patrickbuco08/sugarcane-system/docs/images/ca3f5f8f-66e3-44d3-900d-84d682a41a90.jpeg

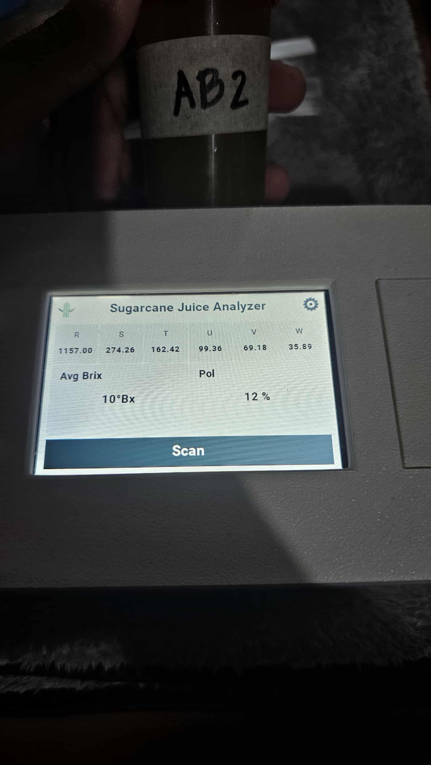
docs/images/ca3f5f8f-66e3-44d3-900d-84d682a41a90.jpeg
