patrickbuco08/sugarcane-system/docs/images/af6ad484-1343-4f59-851e-ec697a815010.jpeg

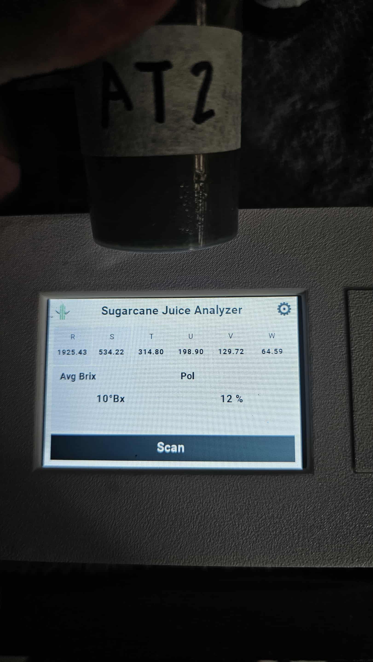
docs/images/af6ad484-1343-4f59-851e-ec697a815010.jpeg
