patrickbuco08/sugarcane-system/README.md

# sugarcane-system

## getting "The file will have its original line endings in your working directory"??
git config --global core.autocrlf true
