patrickbuco08/sugarcane-system/model/README.md

# Sugarcane Yield Prediction Model

This directory contains the machine learning assets for sugarcane yield prediction.

## 🚀 Environment Setup

1. Create a conda environment (Python 3.10)
   ```bash
   conda create -n sugarcane python=3.10
   ```

2. List all available conda environments:
    ```bash
    conda env list
    # or
    conda info --envs
    ```

3. Activate the environment
   ```bash
   conda activate sugarcane
   ```

4. Install dependencies
   ```bash
   conda install pandas numpy scikit-learn matplotlib seaborn jupyter
   ```

If you prefer pip:
```bash
pip install -r requirements.txt
```

## 📁 Project Structure

```
model/
├── README.md                       # This guide
├── train.py            # Training script
└── sugarcane_dataset.csv           # Sample training data template
```

## 🛠 Usage

1. Prepare your dataset following `sugarcane_dataset.csv`.
2. Run the training script:
   ```bash
   python train.py <path/to/sugarcane_dataset.csv>
   ```
3. Check console/log output for metrics and saved artifacts (if implemented in the script).

## Formulas

### Brix
```
Brix = Intercept + (R * Coefficient_R) + (S * Coefficient_S) + (T * Coefficient_T) + (U * Coefficient_U) + (V * Coefficient_V) + (W * Coefficient_W)
```

### Pol
```
Pol = Intercept + (R * Coefficient_R) + (S * Coefficient_S) + (T * Coefficient_T) + (U * Coefficient_U) + (V * Coefficient_V) + (W * Coefficient_W)
```

### compare predictions
```
python compare_predictions.py
```

## 📊 Dependencies

- Python 3.10
- pandas
- numpy
- scikit-learn
- matplotlib (optional: plots)
- seaborn (optional: plots)
- jupyter (optional: notebooks)

## 🔍 Tips

- Ensure your CSV matches the expected columns in `train.py`.
- Use a virtual environment to avoid dependency conflicts.
- Version your datasets and models for reproducibility.

## 🤝 Contributing

1. Create a new branch.
2. Make your changes with clear commit messages.
3. Open a pull request.

## 📝 License

This project is licensed under the MIT License.
