patrickbuco08/sugarcane-system/docs/images/0d0d7b87-3aa7-4536-8bcb-4d0c79ba6991.jpeg

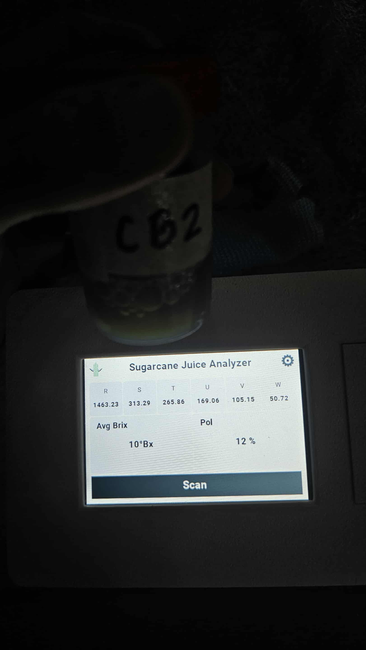
docs/images/0d0d7b87-3aa7-4536-8bcb-4d0c79ba6991.jpeg
