patrickbuco08/sugarcane-system/docs/images/1b9cdef6-652d-4af6-95f5-f85dae05fc5d.jpeg

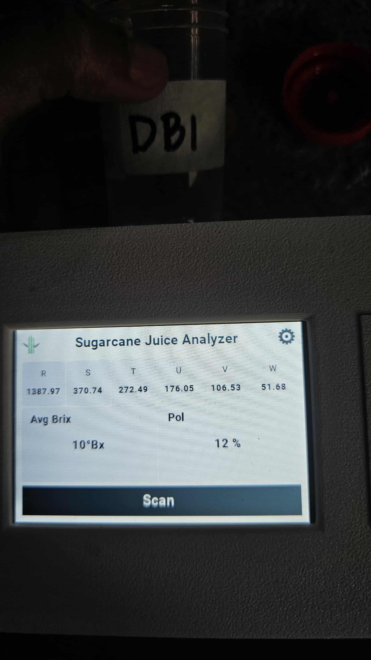
docs/images/1b9cdef6-652d-4af6-95f5-f85dae05fc5d.jpeg
