patrickbuco08/sugarcane-system/docs/images/1bac9211-0c35-43af-a18d-26ac61dd8825.jpeg

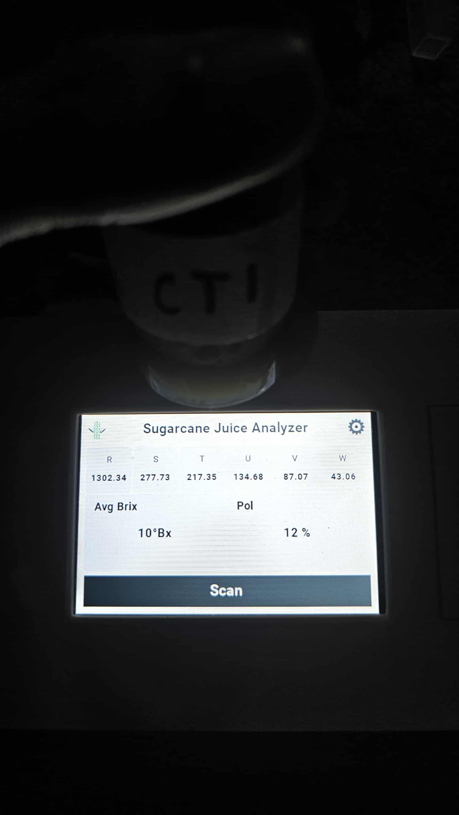
docs/images/1bac9211-0c35-43af-a18d-26ac61dd8825.jpeg
