patrickbuco08/sugarcane-system/docs/images/3c724693-fbf5-43bd-ac4e-58715e780c49.jpeg

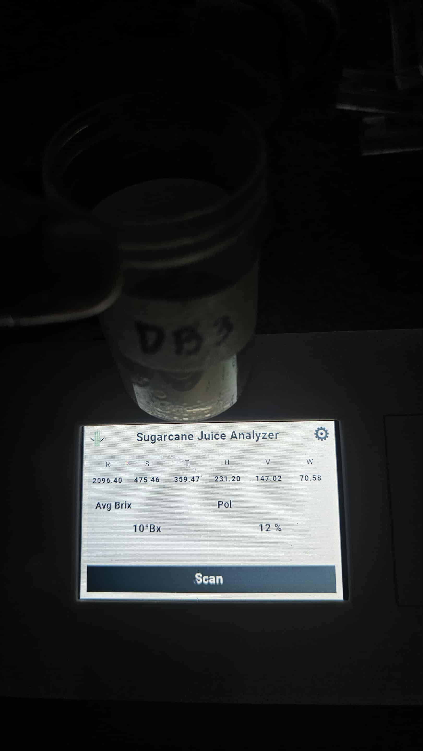
docs/images/3c724693-fbf5-43bd-ac4e-58715e780c49.jpeg
