patrickbuco08/sugarcane-system/docs/images/05ad4cc8-e1f9-4766-a3b2-0679a9f3559e.jpeg

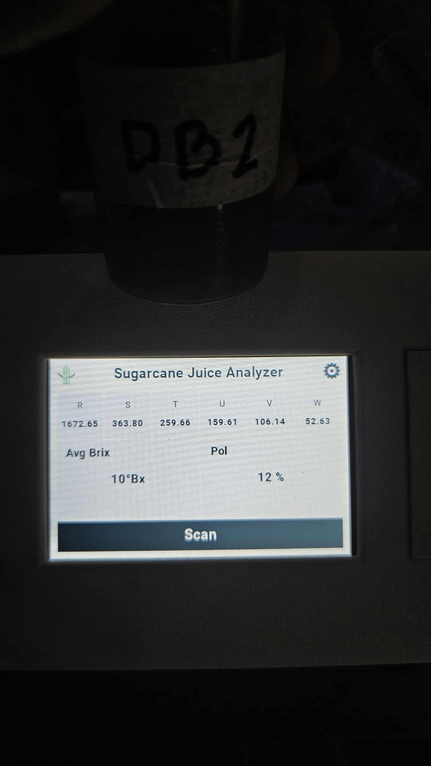
docs/images/05ad4cc8-e1f9-4766-a3b2-0679a9f3559e.jpeg
