patrickbuco08/sugarcane-system/docs/images/6ccf285b-375e-4190-a819-16bb841706b2.jpeg

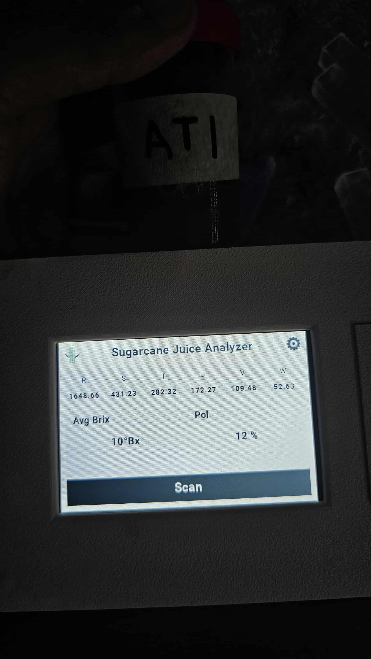
docs/images/6ccf285b-375e-4190-a819-16bb841706b2.jpeg
