patrickbuco08/sugarcane-system/docs/images/7b108888-901c-46f5-8a62-2943c57e6c4b.jpeg

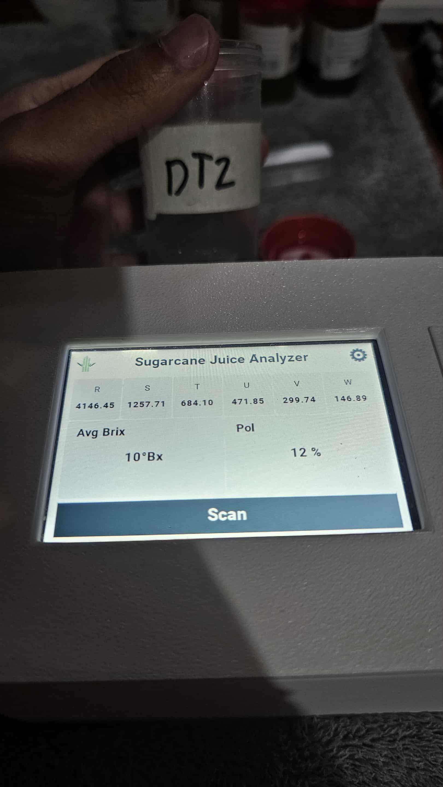
docs/images/7b108888-901c-46f5-8a62-2943c57e6c4b.jpeg
