patrickbuco08/sugarcane-system/docs/images/8acf1e33-d534-42b8-972c-b1b3c7cef1ff.jpeg

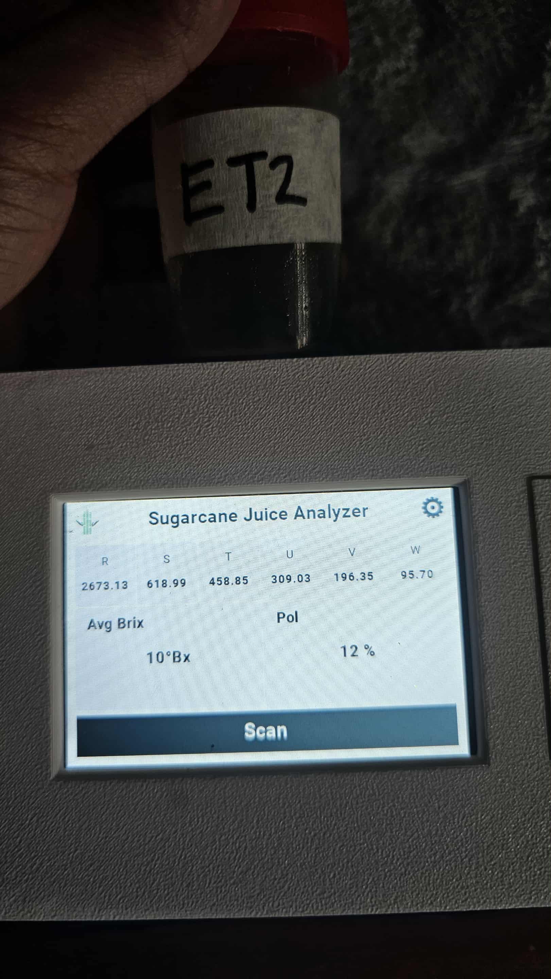
docs/images/8acf1e33-d534-42b8-972c-b1b3c7cef1ff.jpeg
