patrickbuco08/sugarcane-system/docs/images/9fb0ab20-7d77-44ea-ab5d-9b9a8afbc824.jpeg

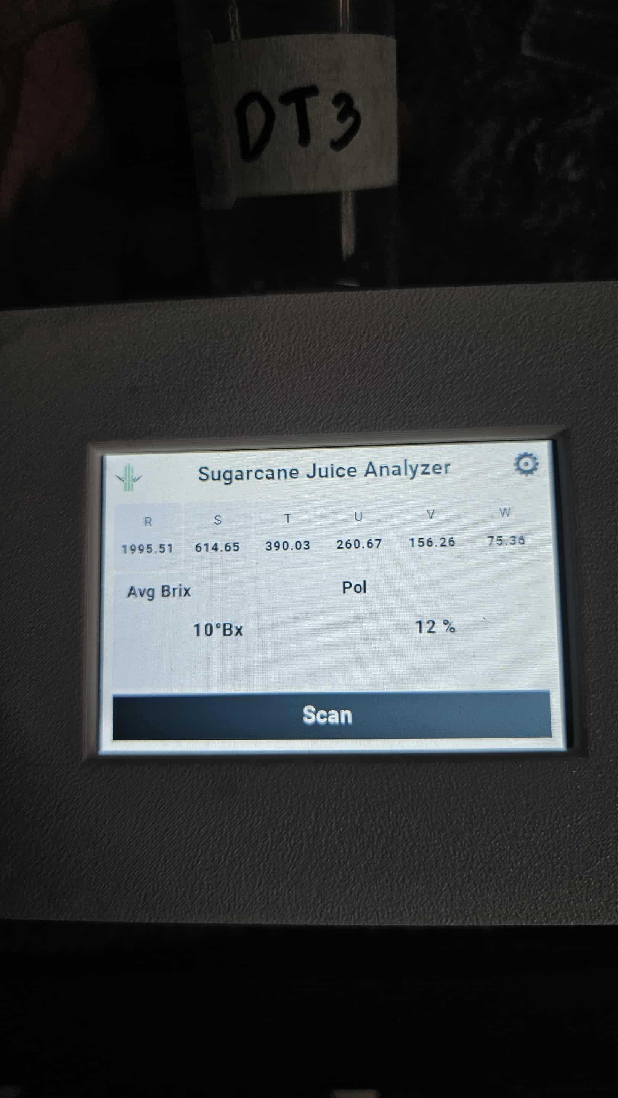
docs/images/9fb0ab20-7d77-44ea-ab5d-9b9a8afbc824.jpeg
