patrickbuco08/sugarcane-system/docs/images/34d0c28a-2cec-43b3-86b0-2dbcf392f2a3.jpeg

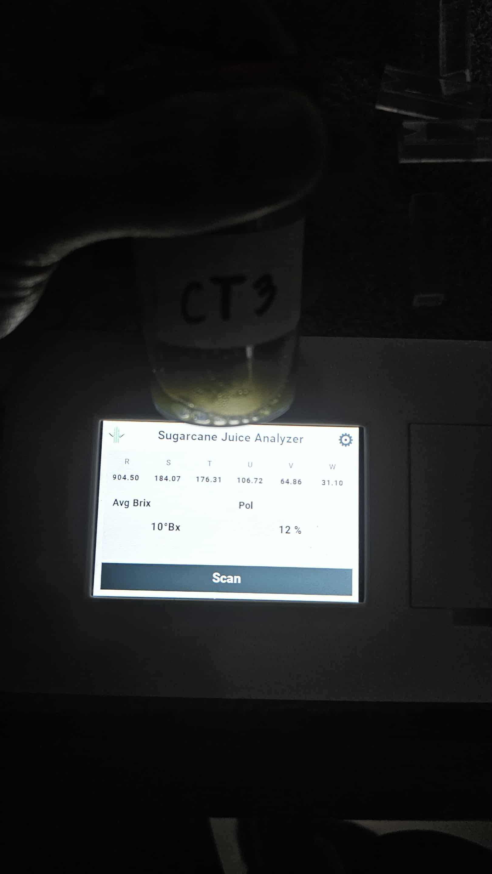
docs/images/34d0c28a-2cec-43b3-86b0-2dbcf392f2a3.jpeg
