patrickbuco08/sugarcane-system/docs/images/43f1e836-a402-4206-a96f-d187ac1180a9.jpeg

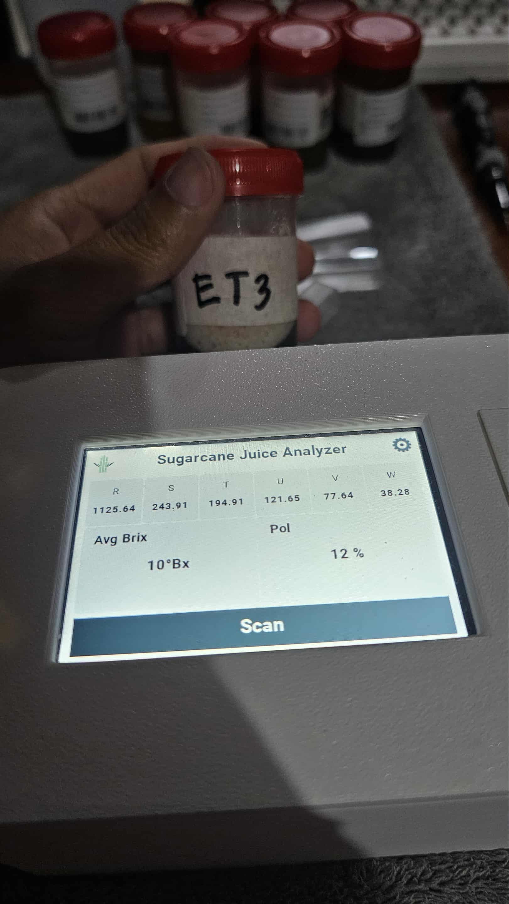
docs/images/43f1e836-a402-4206-a96f-d187ac1180a9.jpeg
