patrickbuco08/sugarcane-system/docs/images/47b05fc7-6812-40f8-93ec-f37b07b2d239.jpeg

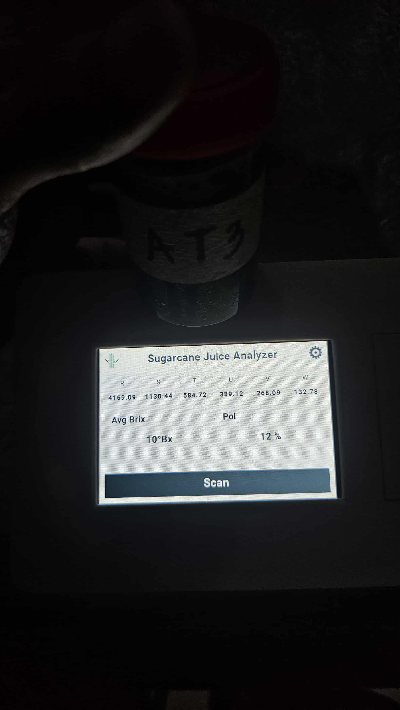
docs/images/47b05fc7-6812-40f8-93ec-f37b07b2d239.jpeg
