patrickbuco08/sugarcane-system/docs/images/57d3f323-b372-4297-8f44-9628997a7a36.jpeg

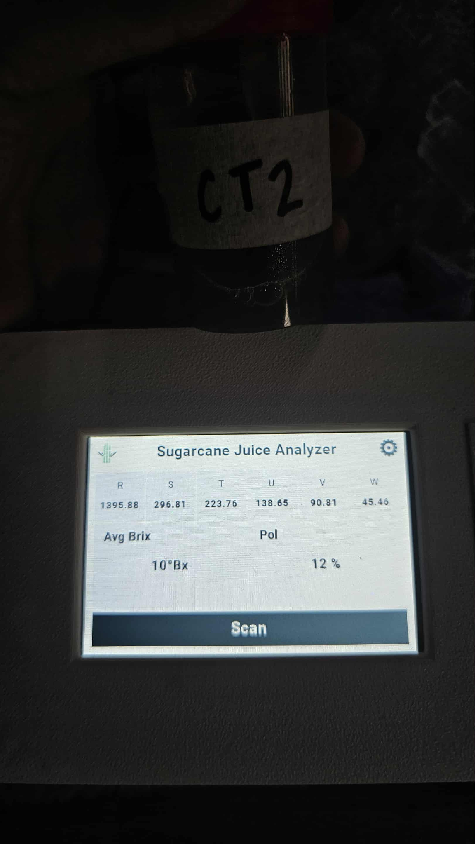
docs/images/57d3f323-b372-4297-8f44-9628997a7a36.jpeg
