patrickbuco08/sugarcane-system/docs/images/61f1e5ee-3955-455a-9479-f2e9a472deef.jpeg

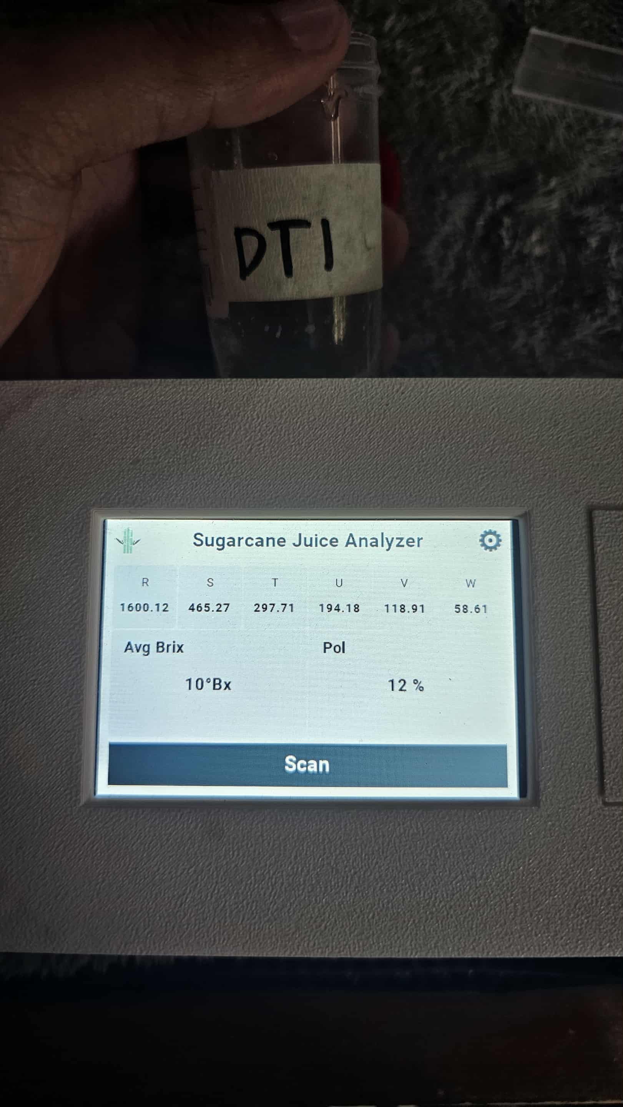
docs/images/61f1e5ee-3955-455a-9479-f2e9a472deef.jpeg
