patrickbuco08/sugarcane-system/docs/images/975b32c4-0c78-48cd-9f11-4fb7340f848e.jpeg

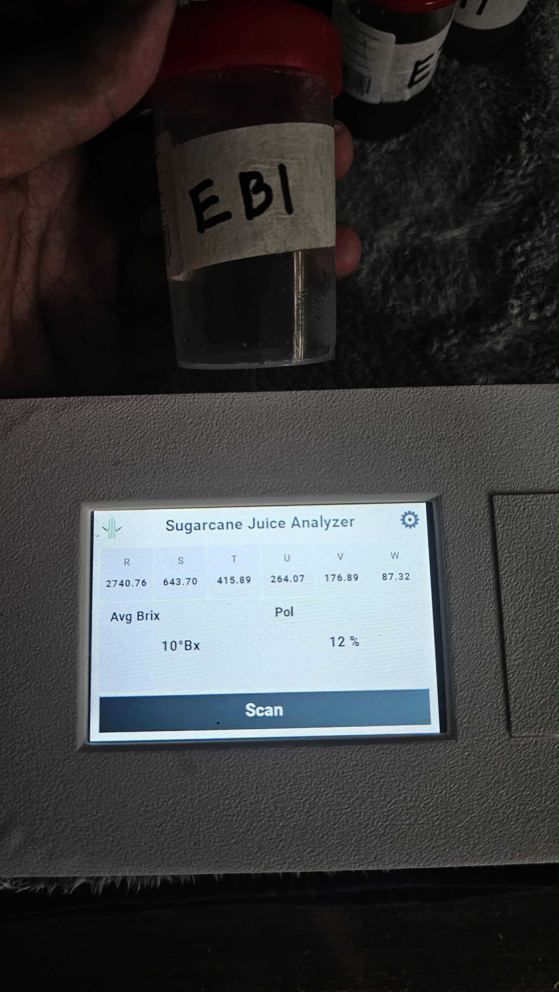
docs/images/975b32c4-0c78-48cd-9f11-4fb7340f848e.jpeg
