patrickbuco08/sugarcane-system/docs/images/2262e3dd-3c30-4b59-8017-70b0b3c801ab.jpeg

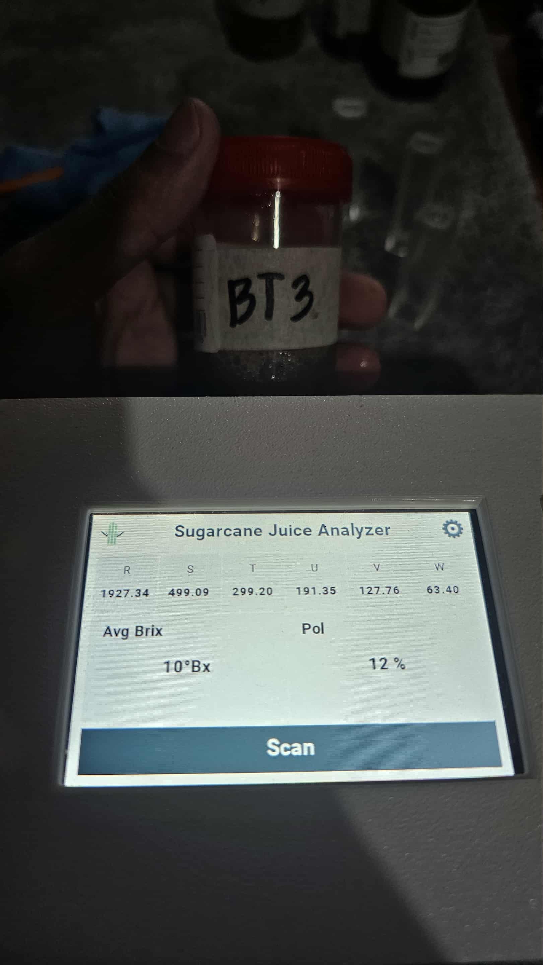
docs/images/2262e3dd-3c30-4b59-8017-70b0b3c801ab.jpeg
