patrickbuco08/sugarcane-system/docs/images/3924c2f6-bb3a-47af-be68-ce7317d07a22.jpeg

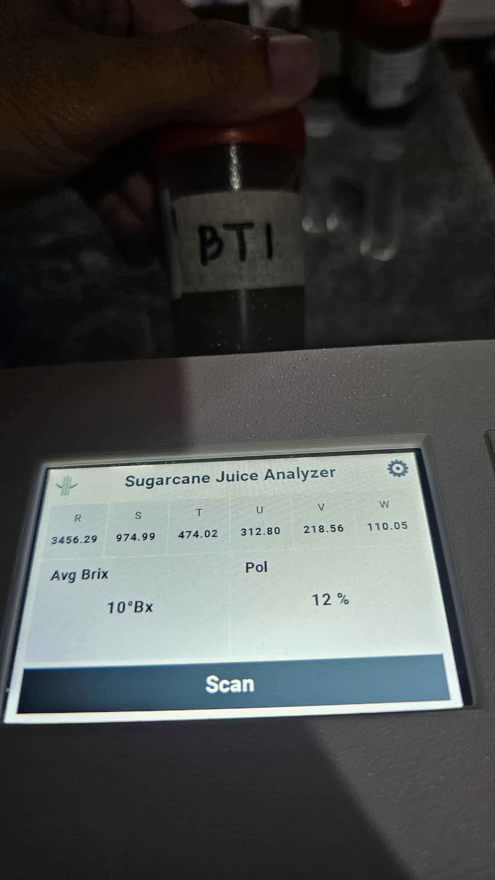
docs/images/3924c2f6-bb3a-47af-be68-ce7317d07a22.jpeg
