patrickbuco08/sugarcane-system/docs/images/6356c0f8-9188-4620-835a-6db2b9c57e00.jpeg

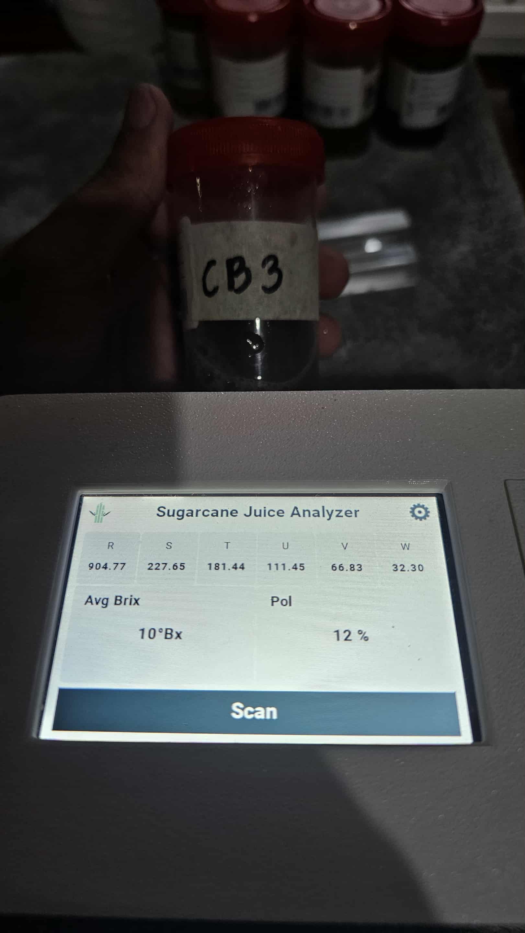
docs/images/6356c0f8-9188-4620-835a-6db2b9c57e00.jpeg
