patrickbuco08/sugarcane-system/docs/images/9030d49b-7fb4-4a3e-9395-ef0e4ffc5972.jpeg

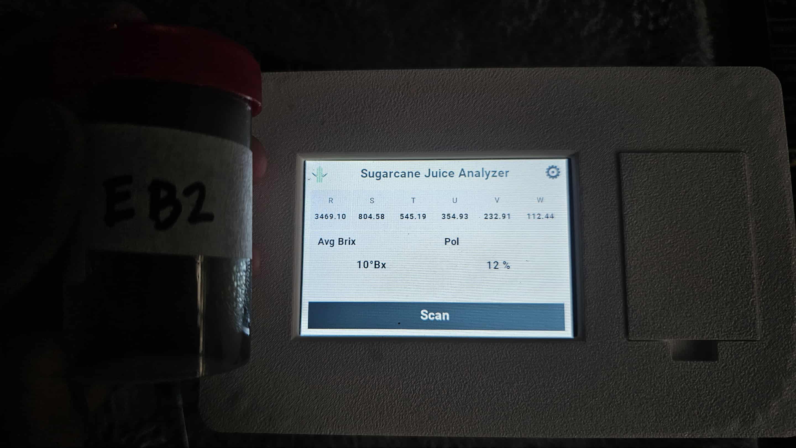
docs/images/9030d49b-7fb4-4a3e-9395-ef0e4ffc5972.jpeg
