patrickbuco08/sugarcane-system/docs/images/47882ea6-a7e0-4213-98d8-7d89c903495a.jpeg

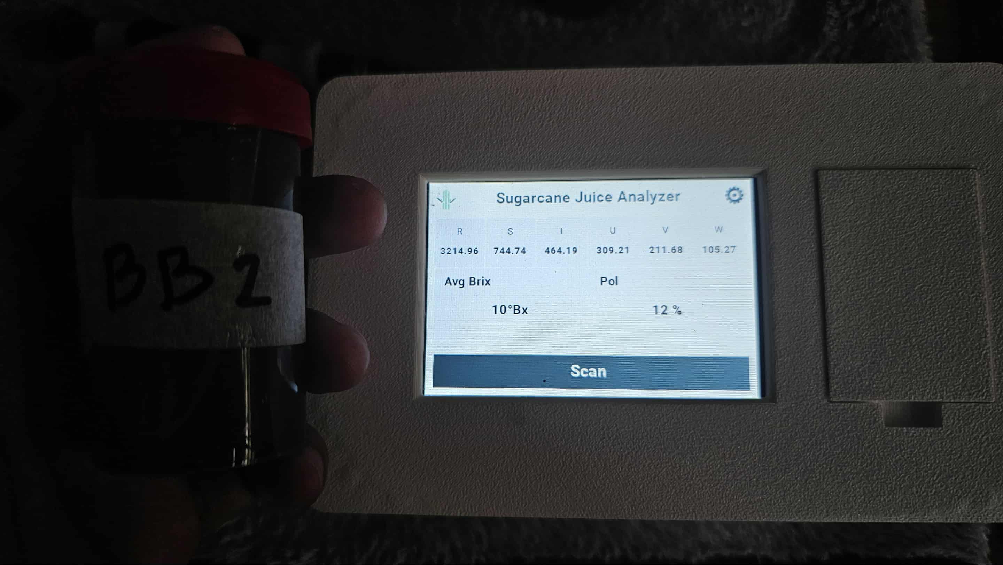
docs/images/47882ea6-a7e0-4213-98d8-7d89c903495a.jpeg
