patrickbuco08/sugarcane-system/docs/images/5977477c-1a16-4199-bb8b-049e392d7cb3.jpeg

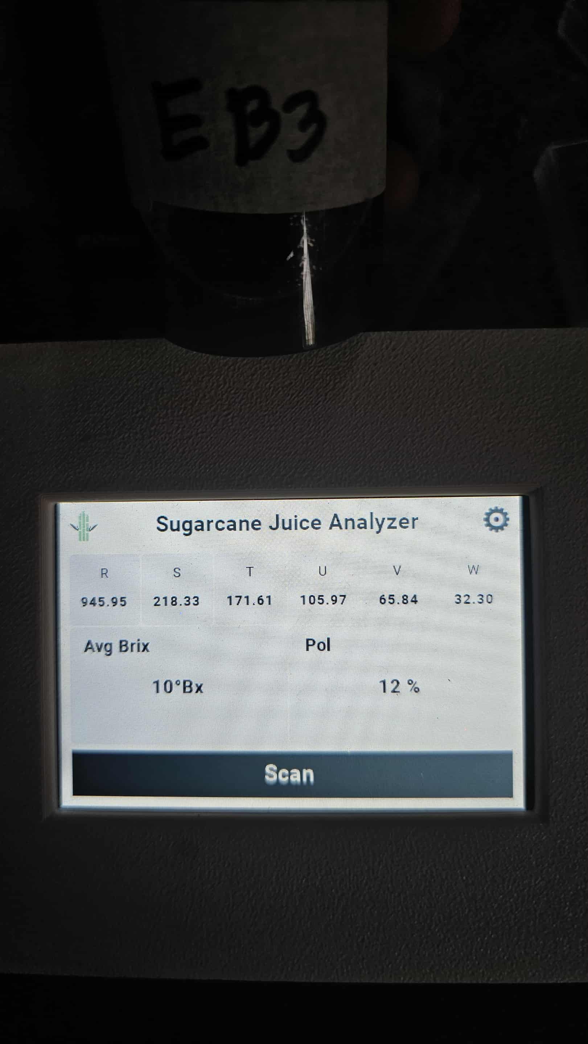
docs/images/5977477c-1a16-4199-bb8b-049e392d7cb3.jpeg
