patrickbuco08/sugarcane-system/docs/images/9213666a-6e60-46cd-840b-3d59be7f91e1.jpeg

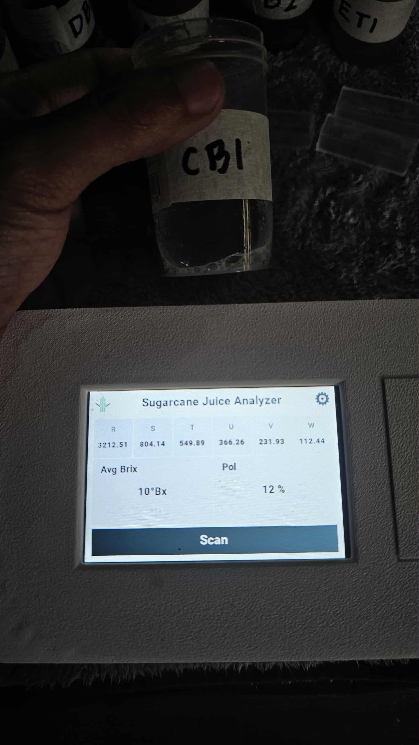
docs/images/9213666a-6e60-46cd-840b-3d59be7f91e1.jpeg
