patrickbuco08/sugarcane-system/docs/images/bab60cea-1f95-4b94-a77f-7723fccf83bc.jpeg

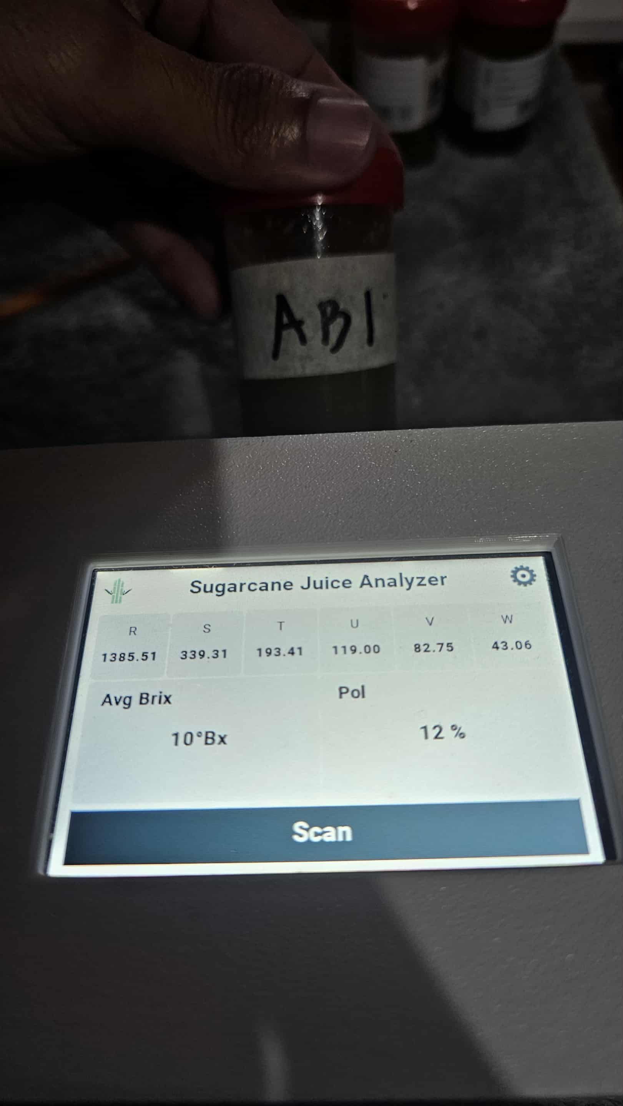
docs/images/bab60cea-1f95-4b94-a77f-7723fccf83bc.jpeg
