patrickbuco08/sugarcane-system/docs/images/d01dd9e1-fc85-46fd-8b8a-94105ae12363.jpeg

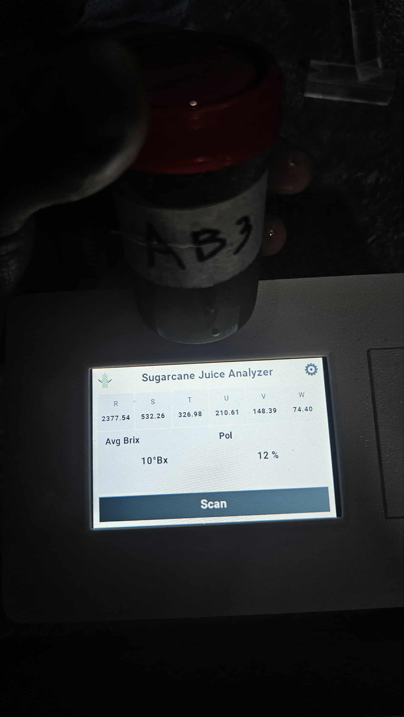
docs/images/d01dd9e1-fc85-46fd-8b8a-94105ae12363.jpeg
