patrickbuco08/sugarcane-system/docs/images/d9b72b43-bb55-482a-9d1f-8d936d5cece5.jpeg

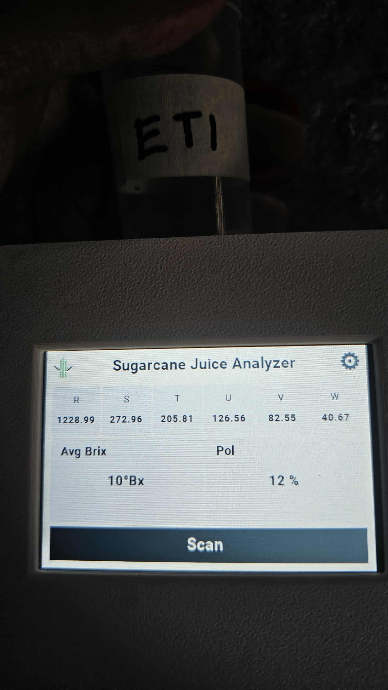
docs/images/d9b72b43-bb55-482a-9d1f-8d936d5cece5.jpeg
