patrickbuco08/sugarcane-system/docs/images/e17e0b4e-ee1d-4f05-8c6d-bb1f122c474c.jpeg

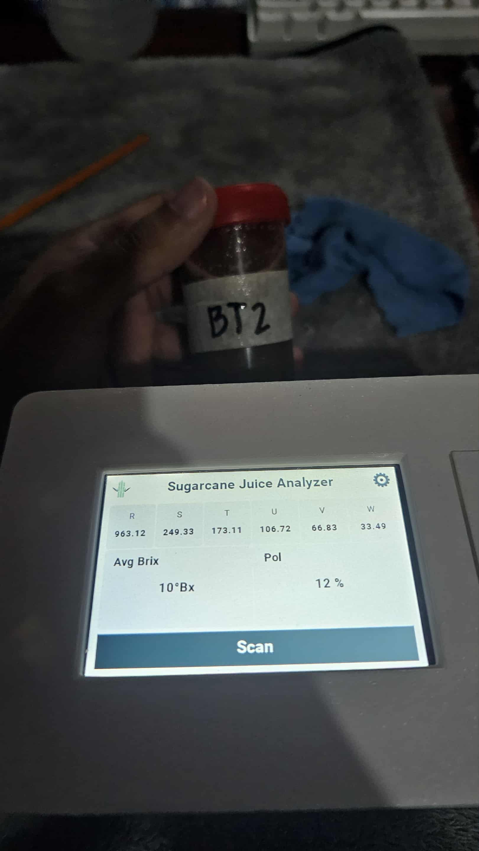
docs/images/e17e0b4e-ee1d-4f05-8c6d-bb1f122c474c.jpeg
