patrickbuco08/sugarcane-system/docs/images/edfc57c8-ef8c-4a97-89cf-6cad12fe098d.jpeg

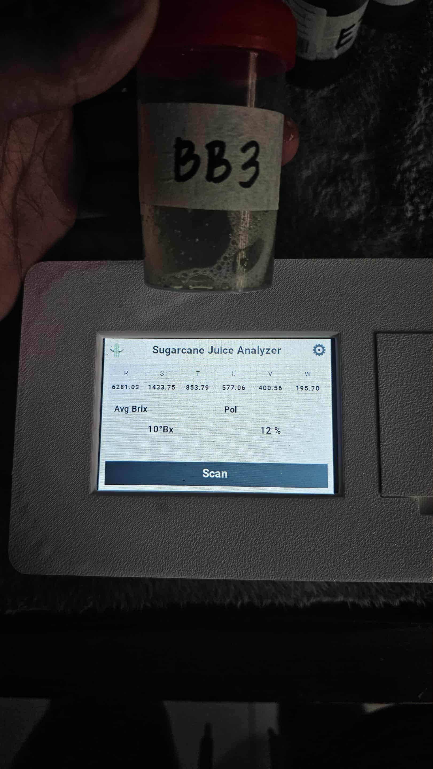
docs/images/edfc57c8-ef8c-4a97-89cf-6cad12fe098d.jpeg
