patrickbuco08/sugarcane-system/docs/images/f0cf5219-f3fd-4e86-bb8d-b80649af0f5d.jpeg

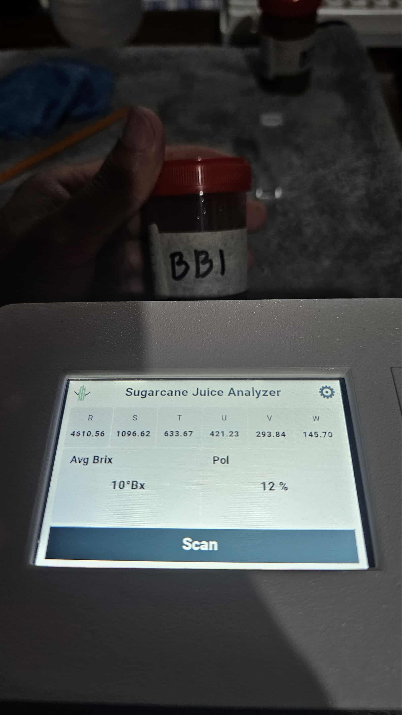
docs/images/f0cf5219-f3fd-4e86-bb8d-b80649af0f5d.jpeg
