patrickbuco08/sugarcane-system/docs/images/zimg1.jpeg

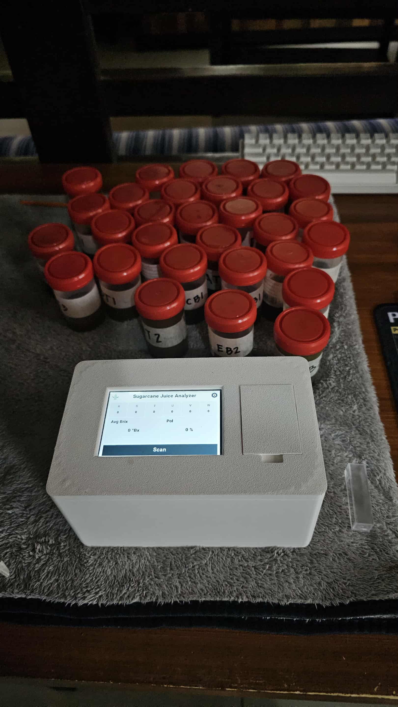
docs/images/zimg1.jpeg
