patrickbuco08/sugarcane-system/docs/images/zimg2.jpeg

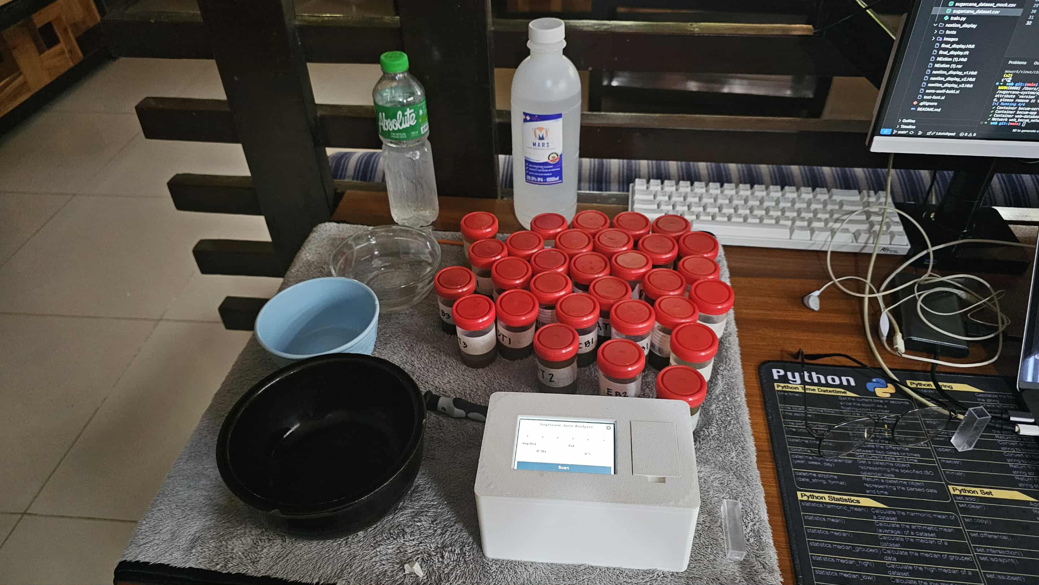
docs/images/zimg2.jpeg
