patrickbuco08/sugarcane-system/docs/images/zimg3.jpeg

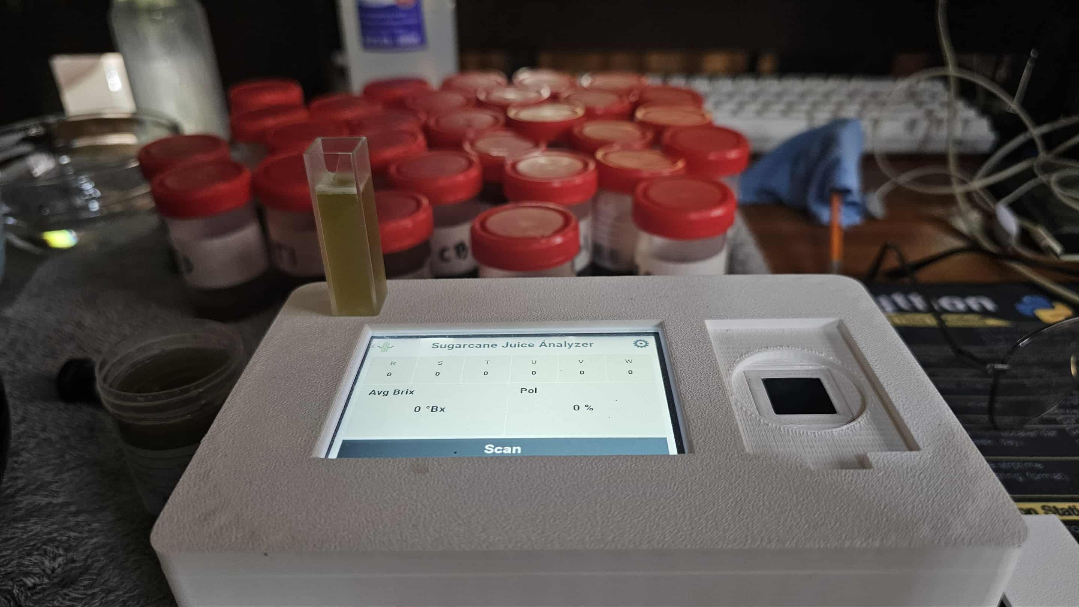
docs/images/zimg3.jpeg
