patrickbuco08/sugarcane-system/docs/laboratory_data.jpg

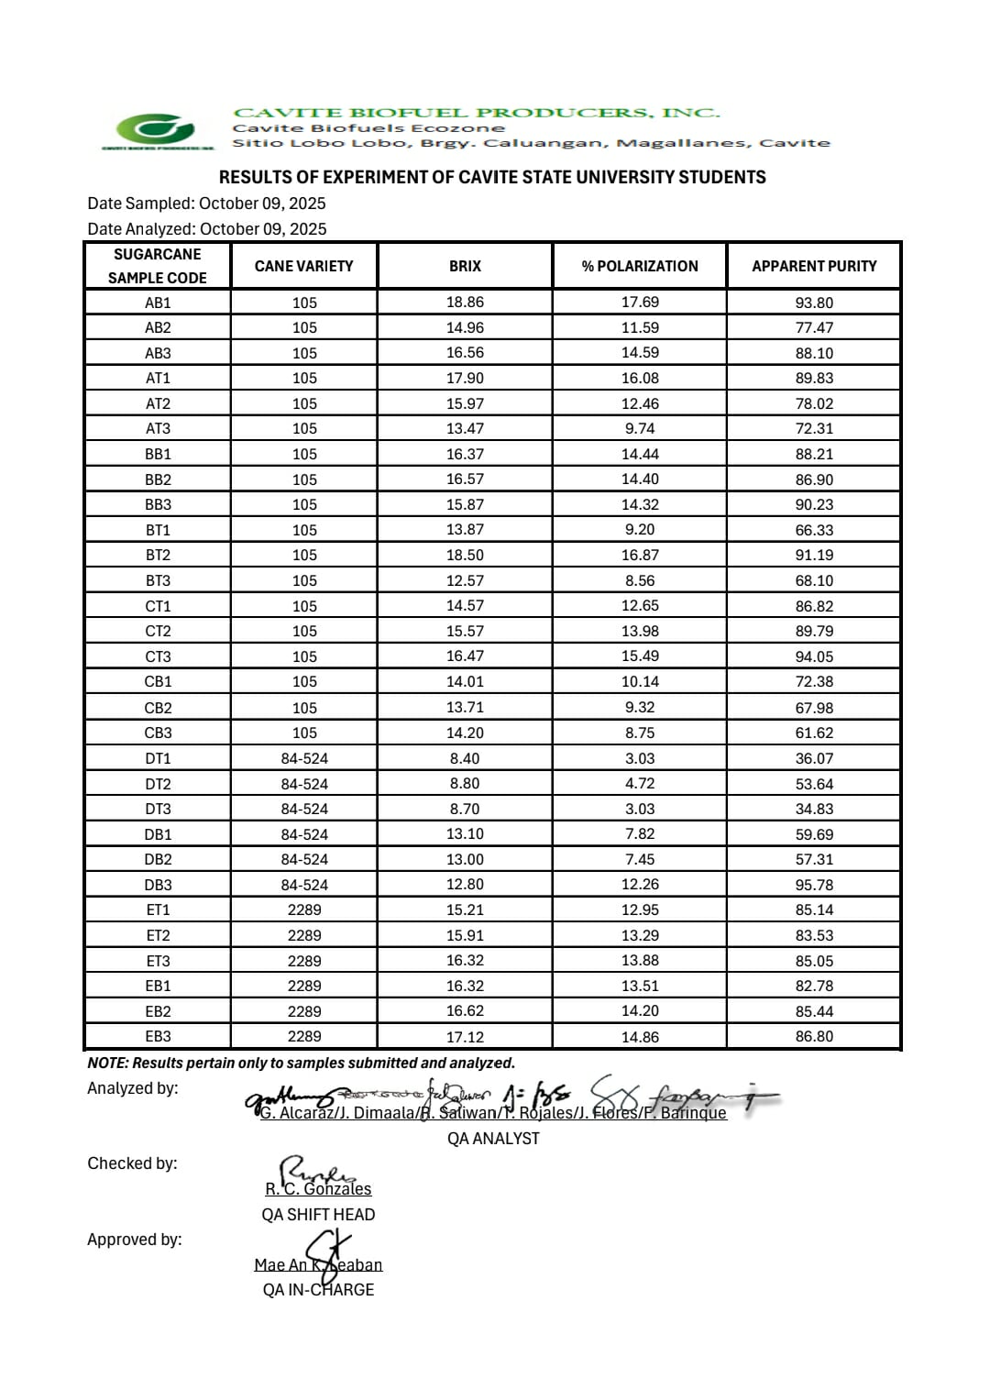
docs/laboratory_data.jpg
