patrickbuco08/sugarcane-system/docs/sugarcane_design_images/img1.png

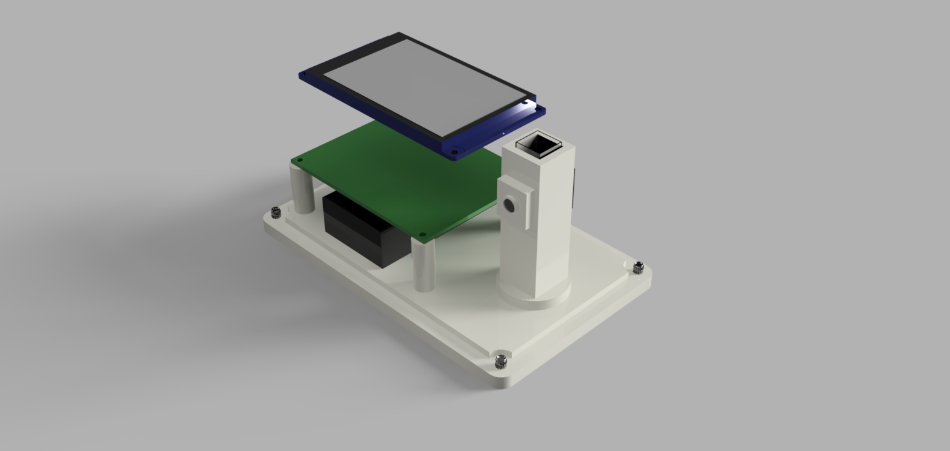
docs/sugarcane_design_images/img1.png
