patrickbuco08/sugarcane-system/docs/sugarcane_design_images/img2.png

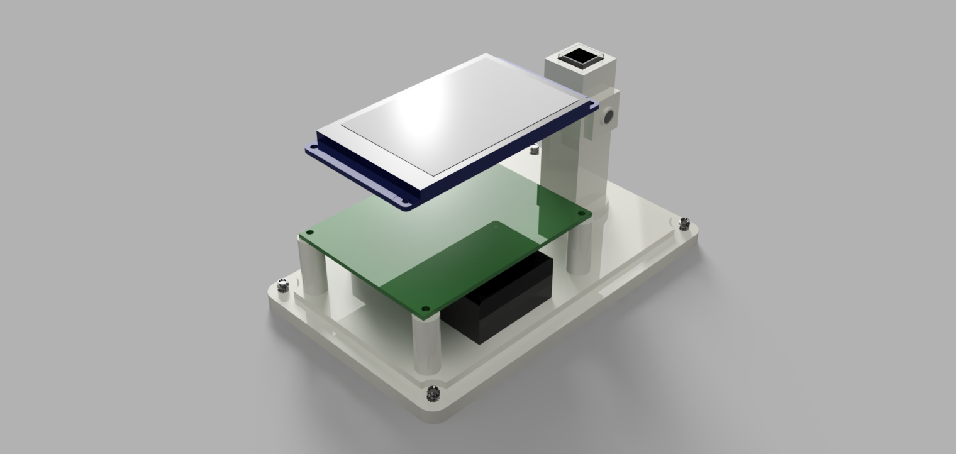
docs/sugarcane_design_images/img2.png
