patrickbuco08/sugarcane-system/docs/sugarcane_design_images/img3.png

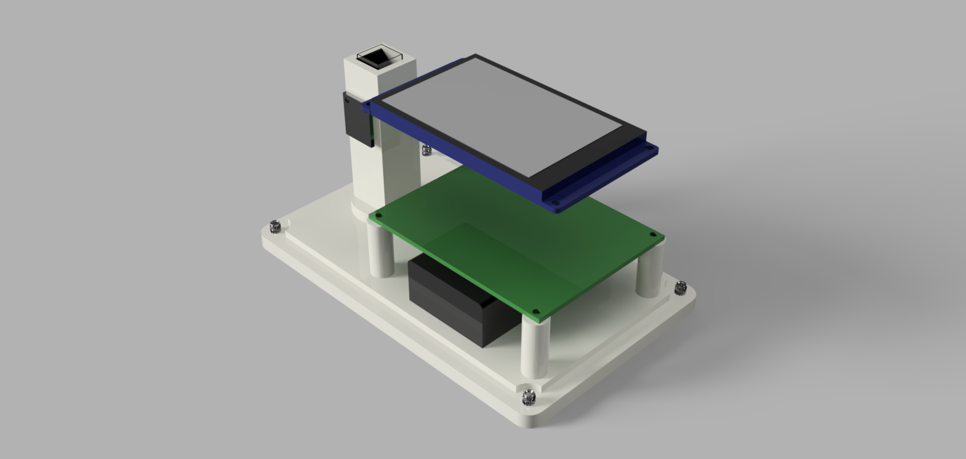
docs/sugarcane_design_images/img3.png
