patrickbuco08/sugarcane-system/docs/sugarcane_design_images/img4.png

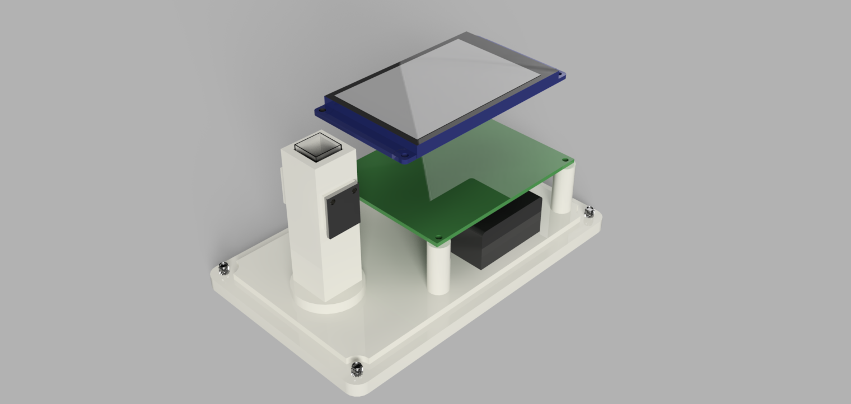
docs/sugarcane_design_images/img4.png
