patrickbuco08/sugarcane-system/docs/sugarcane_design_images/img5.png

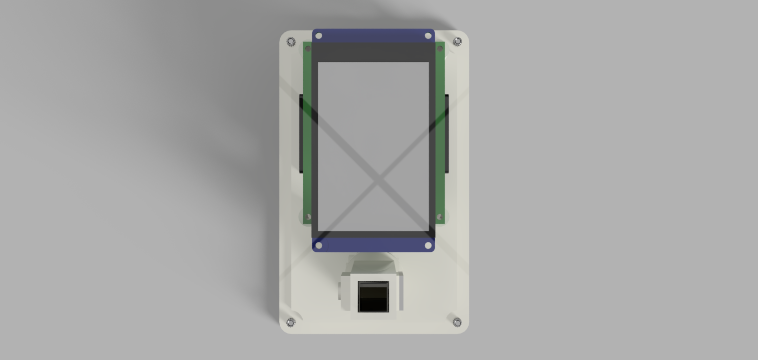
docs/sugarcane_design_images/img5.png
