patrickbuco08/sugarcane-system/docs/sugarcane_design_images/img6.png

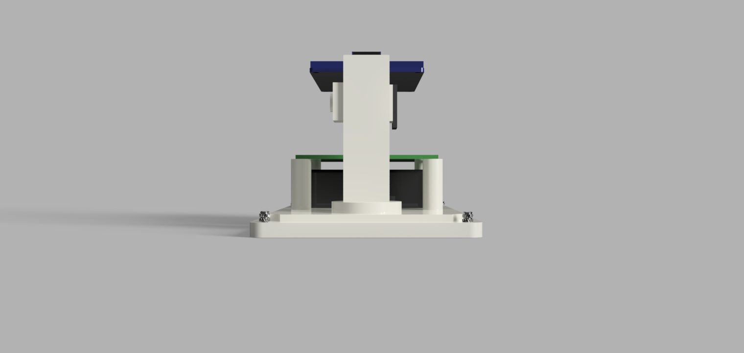
docs/sugarcane_design_images/img6.png
