patrickbuco08/sugarcane-system/docs/sugarcane_design_images/img7.png

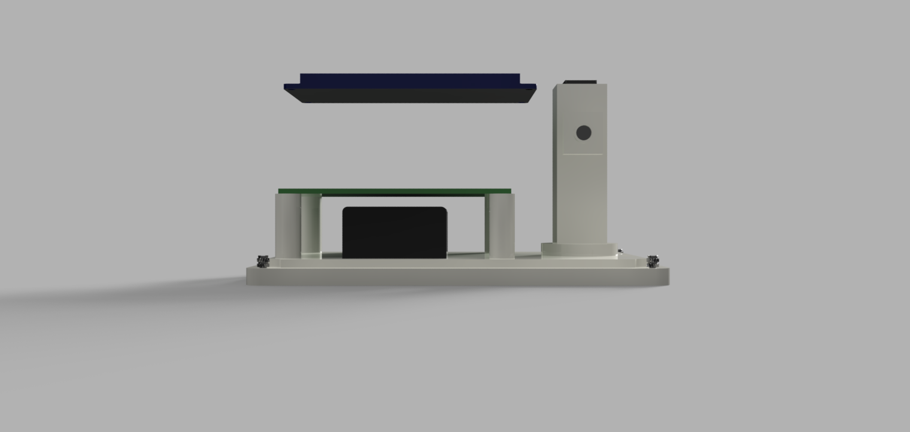
docs/sugarcane_design_images/img7.png
