patrickbuco08/sugarcane-system/docs/sugarcane_design_images/img8.png

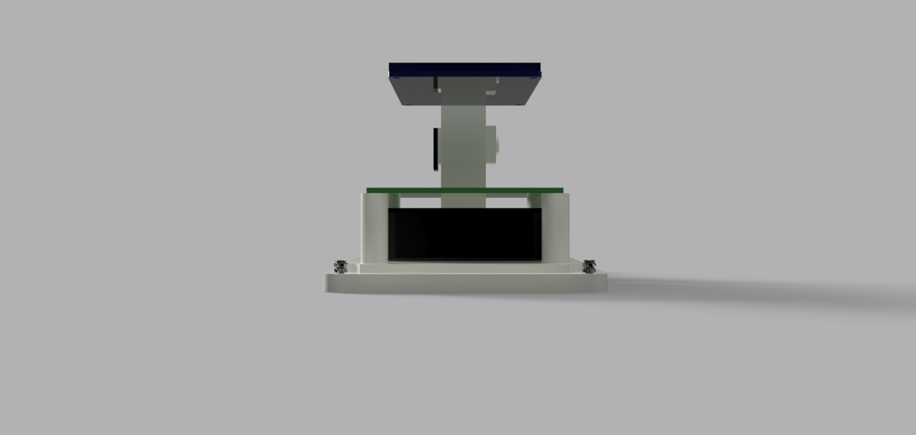
docs/sugarcane_design_images/img8.png
