patrickbuco08/sugarcane-system/docs/sugarcane_design_images/img9.png

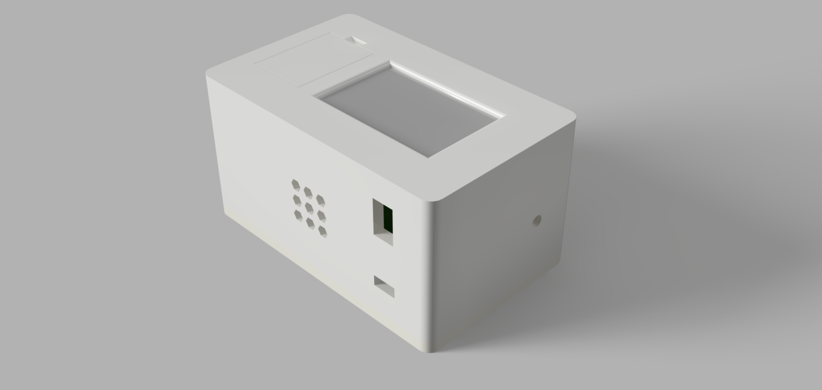
docs/sugarcane_design_images/img9.png
