patrickbuco08/sugarcane-system/docs/sugarcane_design_images/img10.png

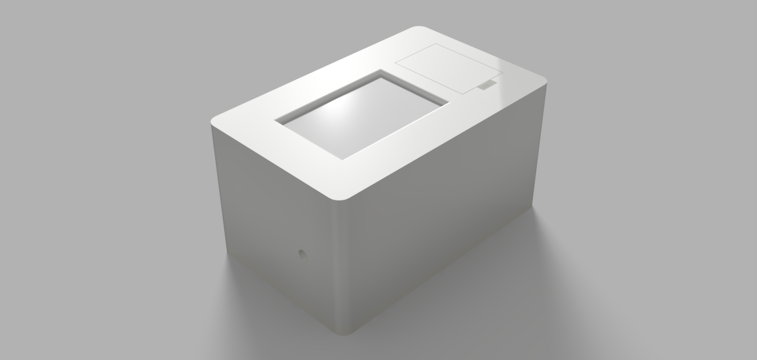
docs/sugarcane_design_images/img10.png
