patrickbuco08/sugarcane-system/docs/sugarcane_design_images/img11.png

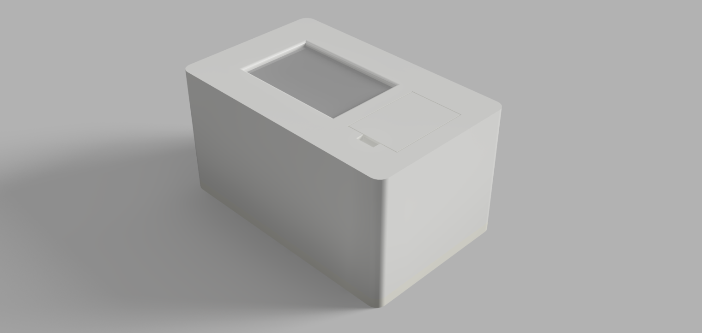
docs/sugarcane_design_images/img11.png
