patrickbuco08/sugarcane-system/docs/sugarcane_design_images/img12.png

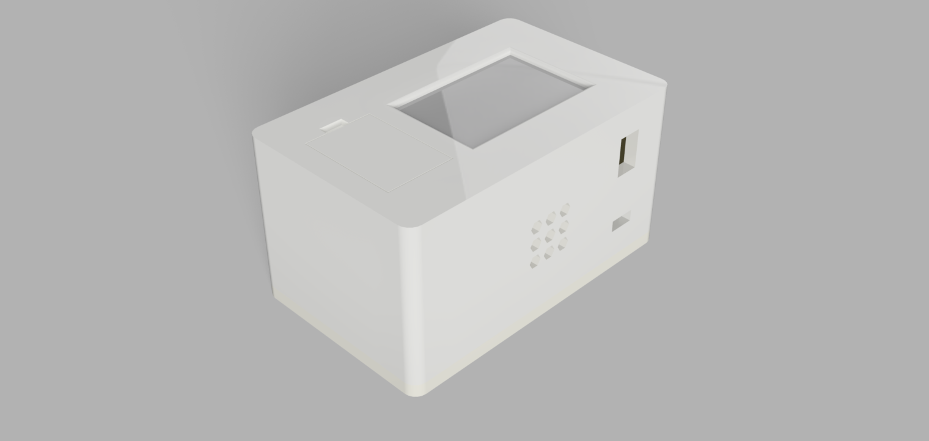
docs/sugarcane_design_images/img12.png
