patrickbuco08/sugarcane-system/docs/sugarcane_design_images/img13.png

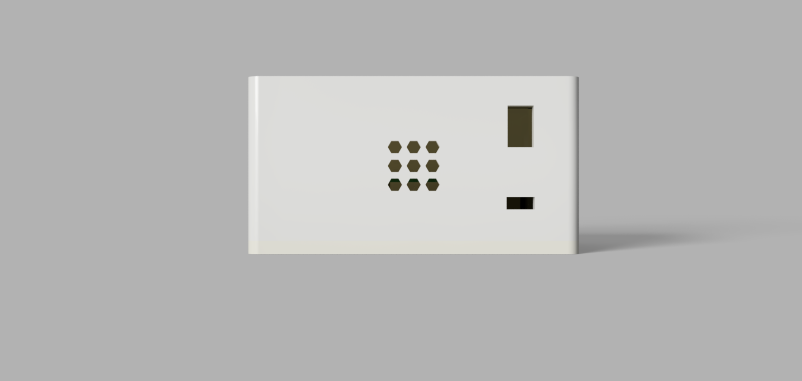
docs/sugarcane_design_images/img13.png
