patrickbuco08/sugarcane-system/docs/sugarcane_design_images/img14.png

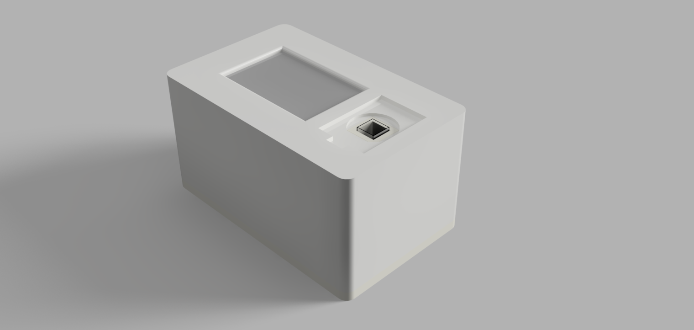
docs/sugarcane_design_images/img14.png
