patrickbuco08/sugarcane-system/docs/sugarcane_design_images/img15.png

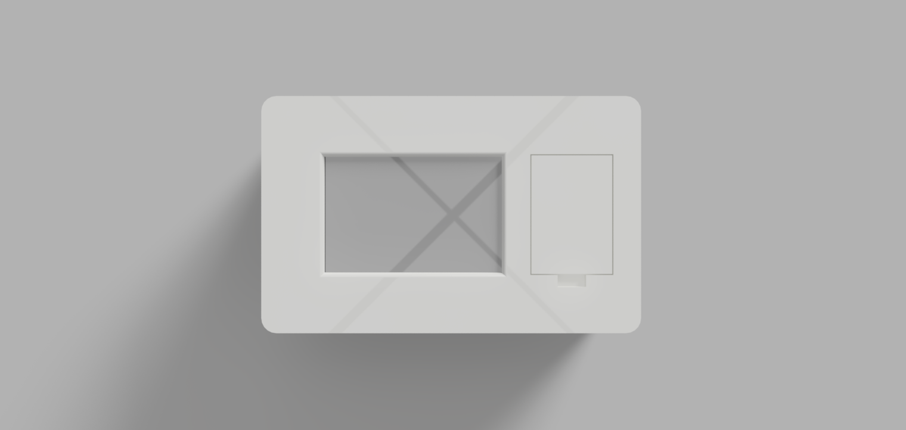
docs/sugarcane_design_images/img15.png
