patrickbuco08/sugarcane-system/docs/sugarcane_design_images/schematic_diagram.png

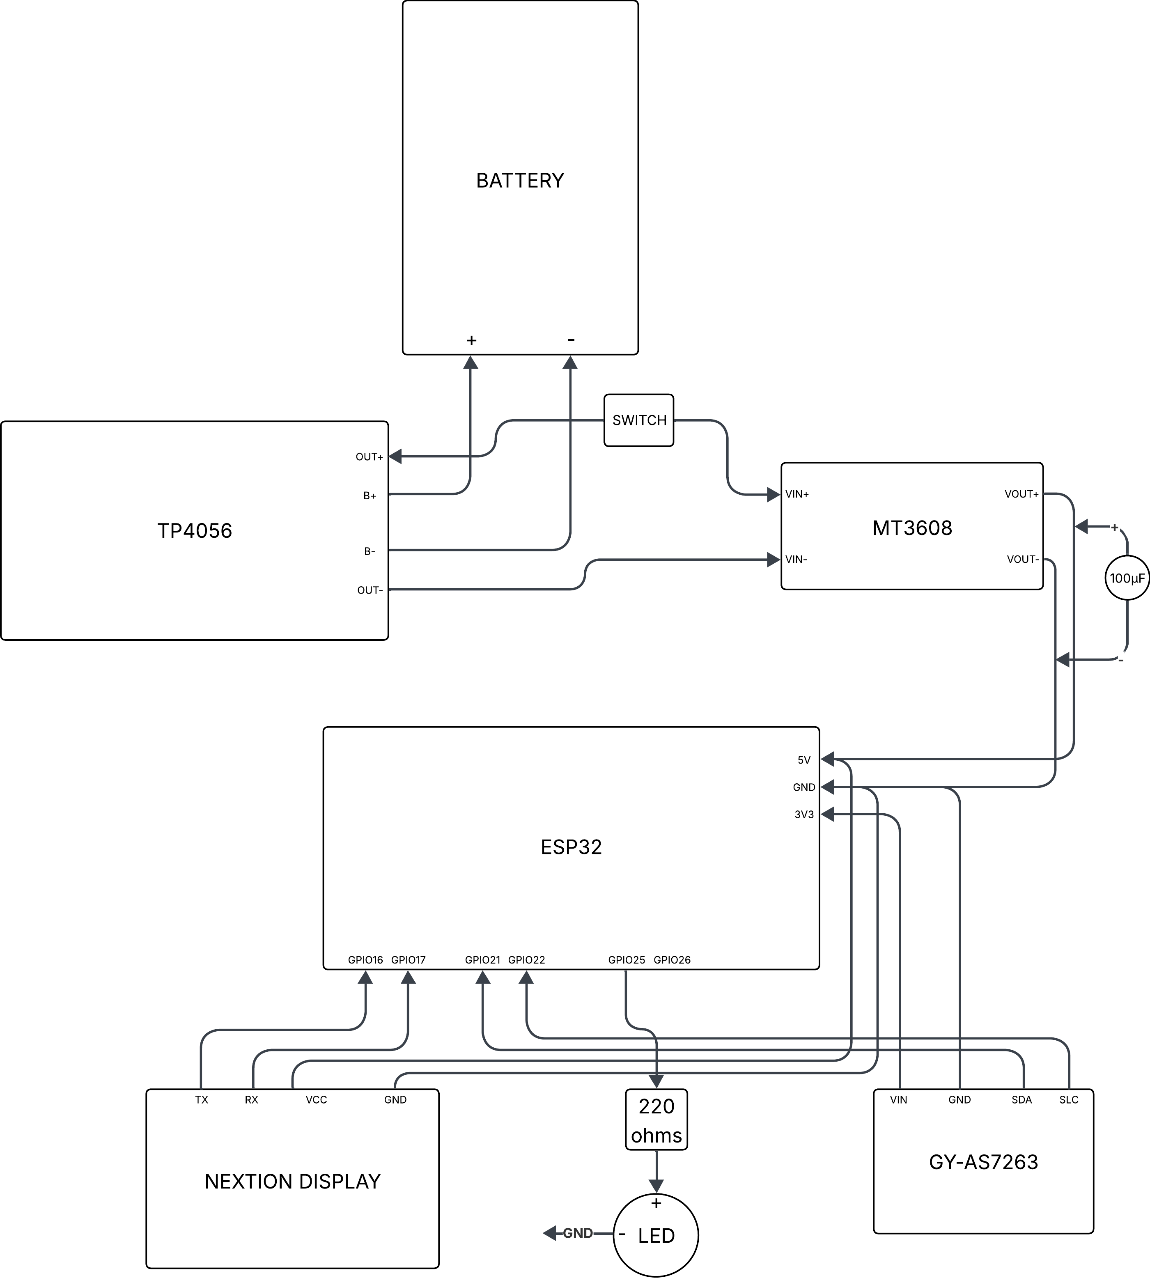
docs/sugarcane_design_images/schematic_diagram.png
