patrickbuco08/sugarcane-system/model/Lasso/lasso_comparison.png

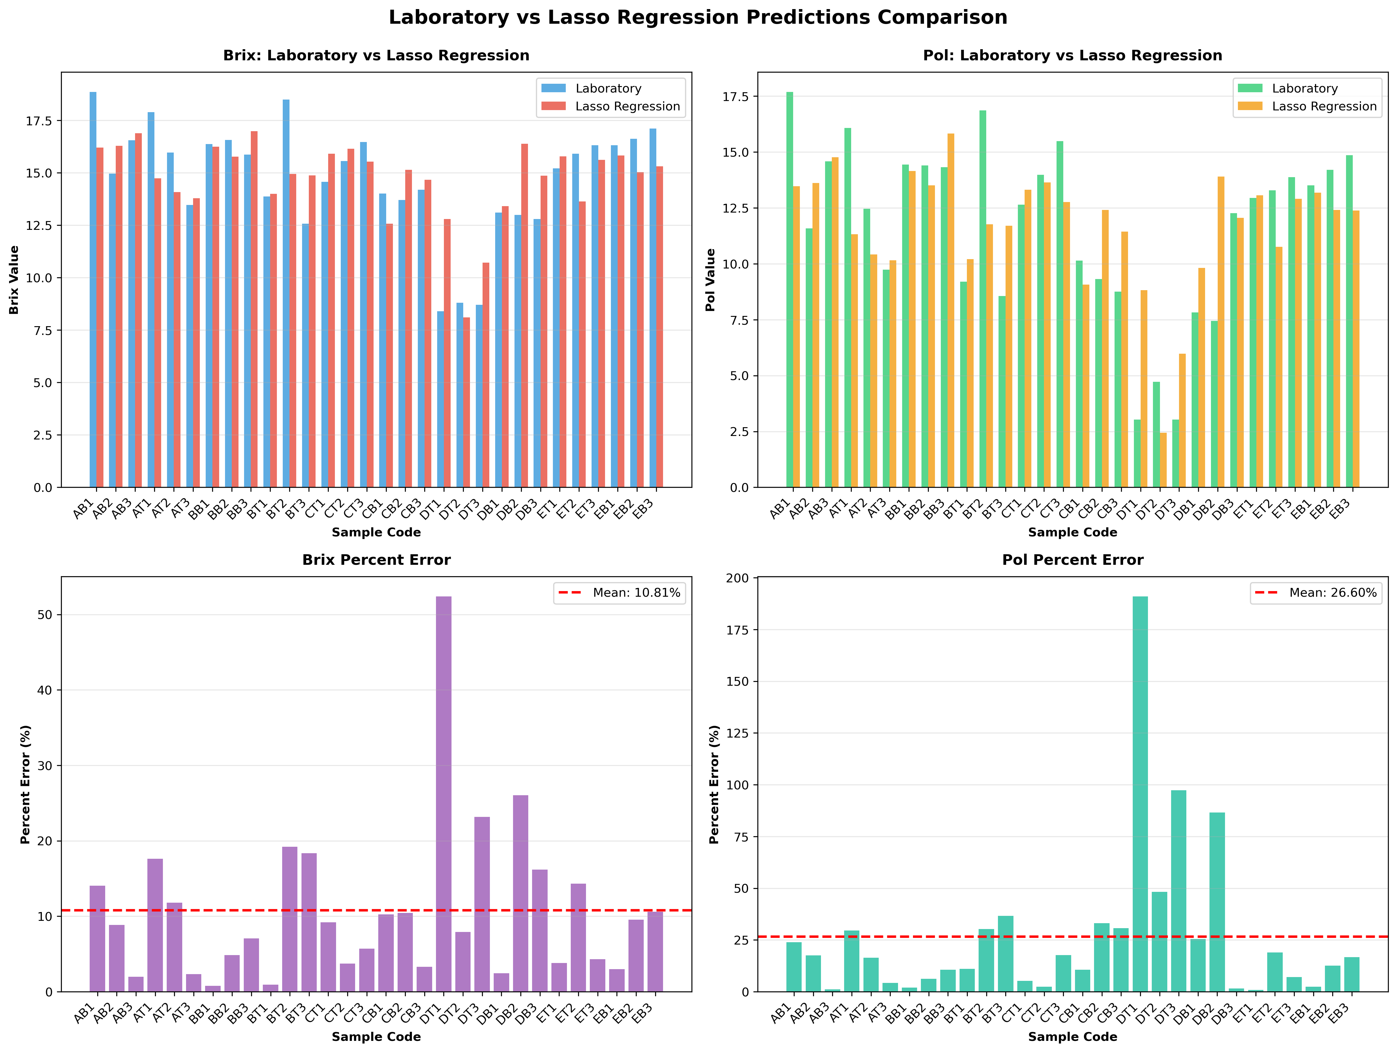
model/Lasso/lasso_comparison.png
