patrickbuco08/sugarcane-system/model/Lasso/lasso_comparison_capped.png

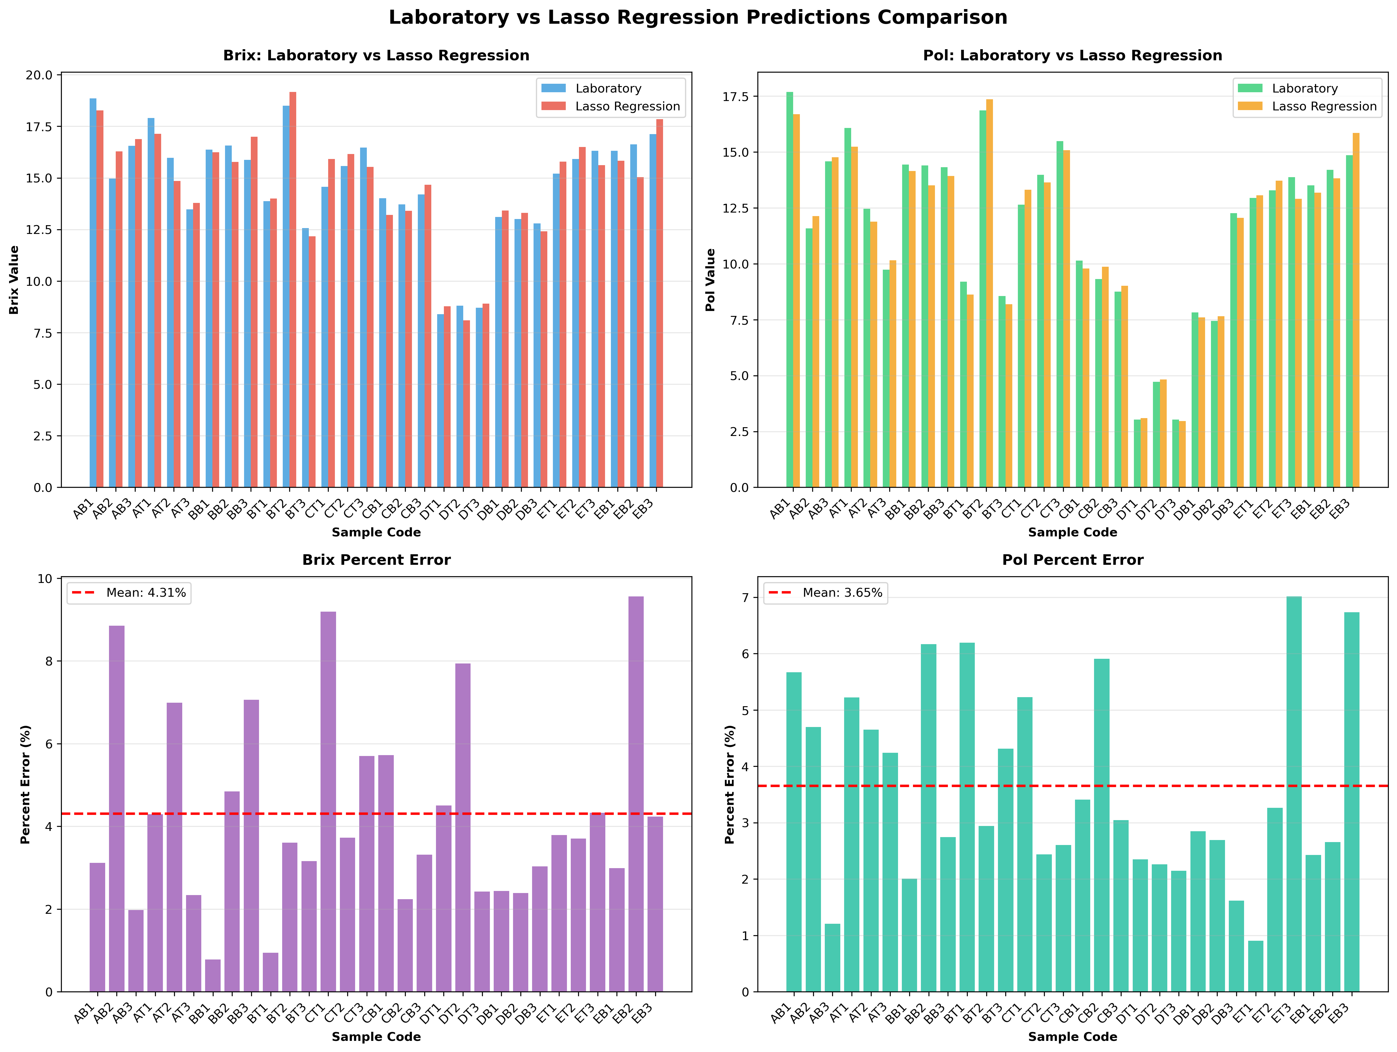
model/Lasso/lasso_comparison_capped.png
