patrickbuco08/sugarcane-system/nextion_display/images/card-layout-v3.png

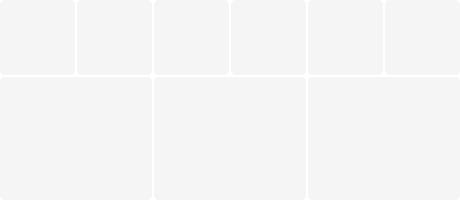
nextion_display/images/card-layout-v3.png
