patrickbuco08/sugarcane-system/nextion_display/images/settings.png

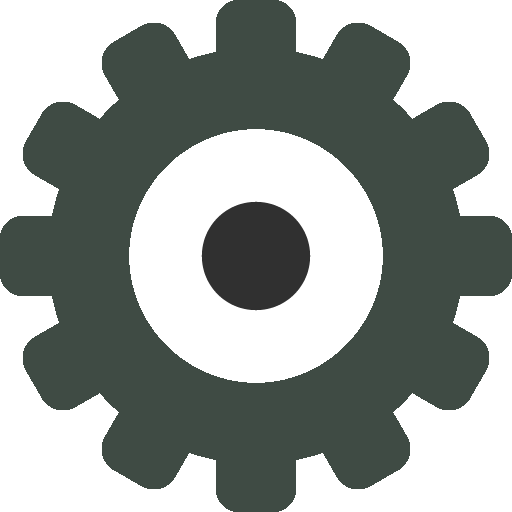
nextion_display/images/settings.png
