patrickbuco08/sugarcane-system/docs/Hardware components.docx

Hardware components

Component | Quantity | Cost
ESP32 Development Board 38 pins | 1 | ₱400
AS7263 Near-Infrared Spectral Sensor | 1 | ₱1500
PCB Board | 1 | ₱50
220 ohms resistor | 1 | ₱20
100µF | 1 | ₱20
Female Header Connector | 1 | ₱50
MT3608 | 1 | ₱60
TP4056 | 1 | ₱33
ENOOK 2PCS Rechargable Battery 18650 3600mAh 3.7V Li-ion FLAT 30A | 1 | ₱500
18650 Parallel Battery Holder Storage Box | 1 | ₱70
Cuvette 4.5ml | 5 | ₱120
Nextion Basic LCD Display Generic 3.5 inch | 1 | ₱2500
1 Box M2, M2.5, M3 brass cropper injection molding knurl | 1 | ₱150
ON/OFF switch | 1 | ₱50
Head Screws Set (M2, M2.5, M3) | 1 | ₱300
Screw 3Pin 5.0mm straight Pin PCB | 6 | ₱120
Type C Female Connector Charging Port | 1 | ₱50
5*1.5mm small round disc magnet | 8 | ₱60
30 AWG Solid Wire 3 meters | 1 | ₱60
TOTAL | | ₱4763
