patrickbuco08/sugarcane-system/model/comparison_results.csv

sample_code | variety | brix | brix_predicted | brix_error | pol | pol_predicted | pol_error
AB1 | 105 | 18.86 | 16.235099308775194 | 13.917819147533434 | 17.69 | 13.966319322270252 | 21.04963639191492
AB2 | 105 | 14.96 | 16.615429739262932 | 11.06570681325489 | 11.59 | 14.679384537512796 | 26.655604292603936
AB3 | 105 | 16.56 | 17.188165511944323 | 3.7932699996637944 | 14.59 | 15.167517031068407 | 3.958307272573042
AT1 | 105 | 17.9 | 14.726658807912948 | 17.7281630842852 | 16.08 | 11.188206437651708 | 30.42160175589733
AT2 | 105 | 15.97 | 13.613393927211156 | 14.756456310512489 | 12.46 | 9.18459585401127 | 26.28735269653877
AT3 | 105 | 13.47 | 14.15873203191127 | 5.113081157470453 | 9.74 | 11.12712864646069 | 14.241567212122074
BB1 | 105 | 16.37 | 16.423764786643012 | 0.32843486037270203 | 14.44 | 14.31093542243893 | 0.893799013580809
BB2 | 105 | 16.57 | 15.875960157047345 | 4.188532546485548 | 14.4 | 13.436708657092623 | 6.689523214634563
BB3 | 105 | 15.87 | 18.389139643431406 | 15.873595736807857 | 14.32 | 19.283838855464552 | 34.66367915827201
BT1 | 105 | 13.87 | 14.047668670839784 | 1.28095653092851 | 9.2 | 10.473238417853167 | 13.839548020143134
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
