patrickbuco08/sugarcane-system/model/comparison_results.png

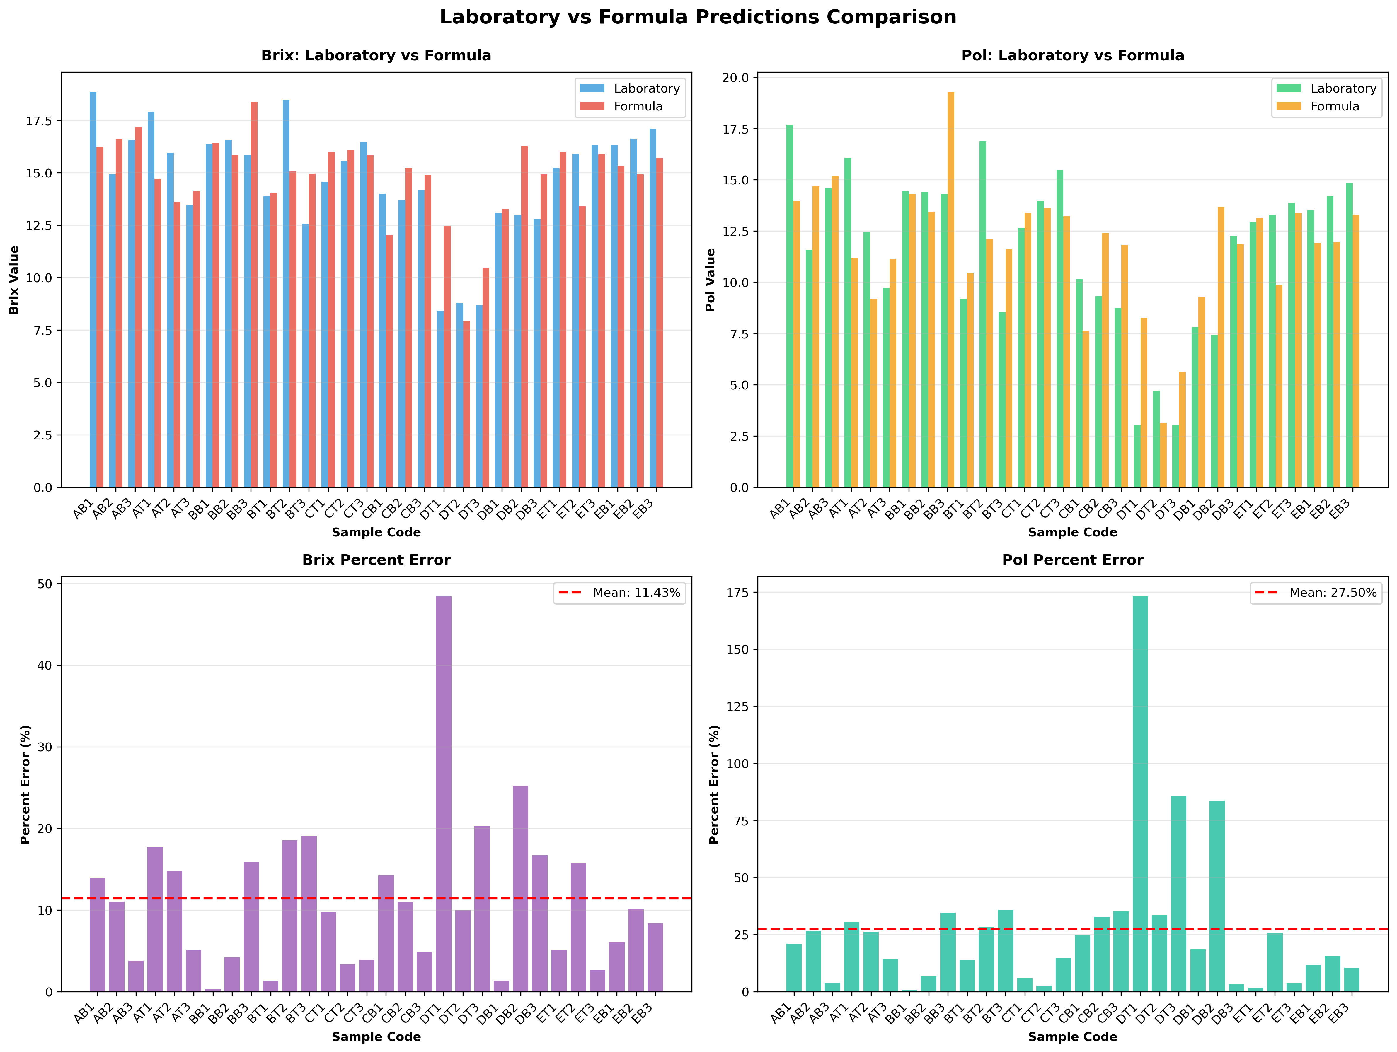
model/comparison_results.png
