patrickbuco08/sugarcane-system/arduino_code/main/config.dist.h

#pragma once

// API Configuration
#define API_BASE_URL "x"
#define API_SECRET "x"

// WiFi Configuration
#define WIFI_SSID "x"
#define WIFI_PASSWORD "x"
#define BOCUM_API_BASE_URL "https://sugarcane.bucocu.net/api"
#define BOCUM_API_SEND_SAMPLE "https://sugarcane.bucocu.net/api/sugarcane-samples"
#define BOCUM_API_PREDICTION_URL "https://sugarcane.bucocu.net/api/predictions"
#define BOCUM_API_TOKEN "thisIsATestToken"
