patrickbuco08/sugarcane-system/(commit log)

2025-09-11 feat: working as7263 code in arduino
2025-09-12 feat: as7263 code for esp32
2025-09-13 feat: averaging method when getting sample
2025-09-15 feat: display samples, harvest batch
2025-10-09 fix: button not working because need to send component ID
2025-10-15 feat: add sugarcane api to create samples
2025-10-15 feat: initial prediction model
    [sugarcane_dataset.csv, sugarcane_dataset_mock.csv]
2025-10-15 feat: initial prediction API
    [sugarcane_dataset_mock.csv]
2025-10-16 feat:updated dataset channels
    [sugarcane_dataset.csv]
2025-10-16 feat: lasso regression
    [comparison_results.csv, lasso_percent_error_export.csv, sugarcane_dataset_mock.csv]
2025-10-16 feat: track latest sample for real time display
2025-10-16 feat: initial esp32 api
2025-10-19 finalize can button API request
2025-10-19 feat: analyze sample via esp32 server endpoint
2025-10-19 feat: add delete sample functionality
2025-10-26 feat: add design screenshots and schematic diagram
2025-11-12 docs: add hardware components list and cost breakdown
    - Added detailed bill of materials (BOM) document listing all hardware components
    - Included quantities and individual costs for each component
    - Listed total cost of ₱4,763 for complete hardware assembly
    - Documented key components including ESP32, AS7263 sensor, display, and power components
